BrainardLab/PennAnomaloscope/Electronics/ShieldFrontBlackPowerWires.jpeg

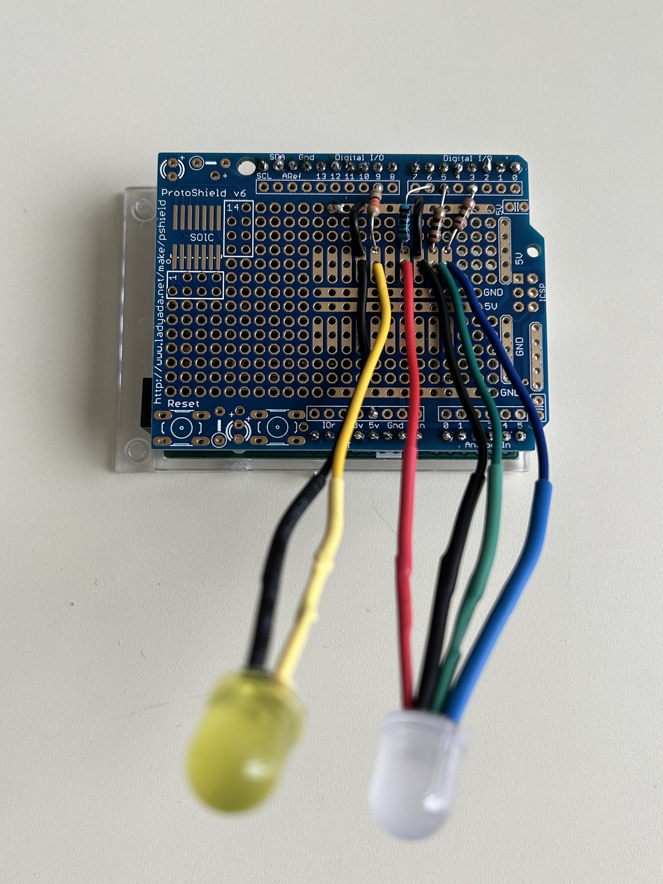
Electronics/ShieldFrontBlackPowerWires.jpeg
