BrainardLab/PennAnomaloscope/Electronics/ShieldBackBlackPowerWires.jpeg

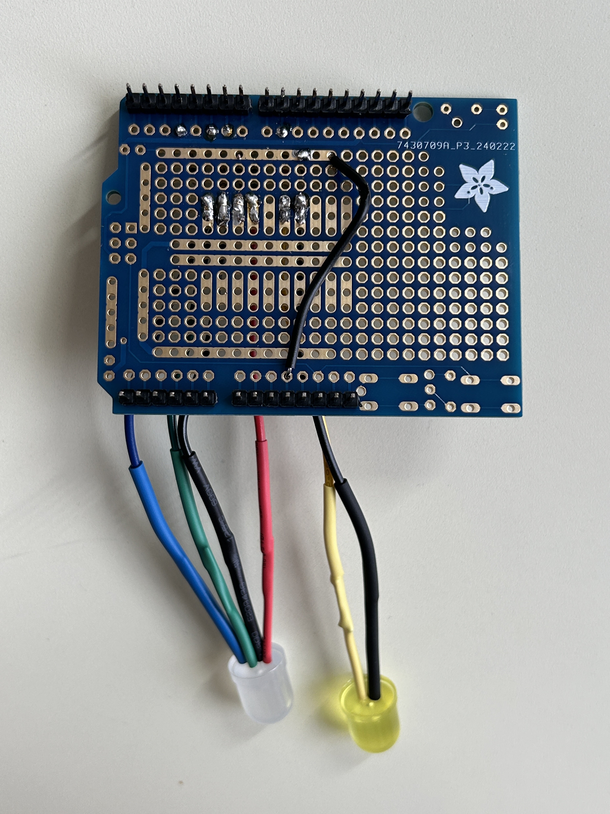
Electronics/ShieldBackBlackPowerWires.jpeg
