BrainardLab/PennAnomaloscope/Electronics/README.md

See the AssemblyInstructions document for instructions.
