BrainardLab/PennAnomaloscope/Electronics/PartsList-02-08-25.xlsx

Date | Company | Product | PID | Link | Price per Unit | # of Units | Cost | Order Cost w/ Tax & Shipping
2019-10-30 | Adafruit | Diffused RGB (tri-color) 10mm LED (10 / order) | 848 | https://www.adafruit.com/product/848 | $9.95 | 1 | $9.95 | $71.06
2019-10-30 | Adafruit | Diffused Yellow 10mm LED (25 / order) | 3260 | https://www.adafruit.com/product/3260 | $9.95 | 1 | $9.95
2019-10-30 | Adafruit | Extra-long 0.1" 16-pin strip male header (5 / order) | 400 | https://www.adafruit.com/product/400 | $3.00 | 5 | $15.00
2019-10-30 | Adafruit | Adafruit Proto Shield for Arduino V:R3 | 2077 | https://www.adafruit.com/product/2077 | $9.95 | 2 | $19.90
2020-03-26 | Prusa | Prusament ASA Natural 850g | PRM-ASA-NAT-850 | https://shop.prusa3d.com/en/prusament/976-prusament-asa-natural-850g.html | $29.99 | 1 | $29.99 | $32.09
2020-11-29 | B&H | Rosco Roscolux #23 Filter - Orange - 20x24" Sheet | BH #RO23S | https://www.bhphotovideo.com/c/product/43934-REG/Rosco_RS2311_23_Filter_Orange.html | $6.95 | 3 | $20.85 | $30.89
2021-05-03 | Prusa | Prusament ASA Signal White 850g | PRM-ASA-SGW-850 | https://shop.prusa3d.com/en/prusament/1318-prusament-asa-signal-white-850g.html | $28.49 | 2 | $56.98 | $72.52
2021-04-26 | Adafruit | Hook-up Wire Spool Set - 22AWG Solid Core | 1311 | https://www.adafruit.com/product/1311 | $15.95 | 1 | $15.95
2021-05-28 | Amazon | Arduino Leonardo with Headers | A000057 | https://www.amazon.com/gp/product/B008FZJC74/ref=ppx_od_dt_b_asin_title_s00?ie=UTF8&psc=1 | $25.15 | 11 | $276.65
 |  |  |  |  |  |  |  | $293.26
Alternates |  | Diffused yellow LED, 611 nm, 10mm diam | not in stock | https://www.digikey.com/en/products/detail/sunled/XLM2MOK01W/4901618?0=%2F605nm
 |  | Diffused yellow LED, 610 nm, 3mm diam | in stock | https://www.digikey.com/en/products/detail/broadcom-limited/HLMP-Y402-G0000/2672647
 |  | Diffused yellow LED, 605 nm, 10mm diam | in stock | https://www.adafruit.com/product/4204
