BrainardLab/PennAnomaloscope/arduino_spectra.pdf

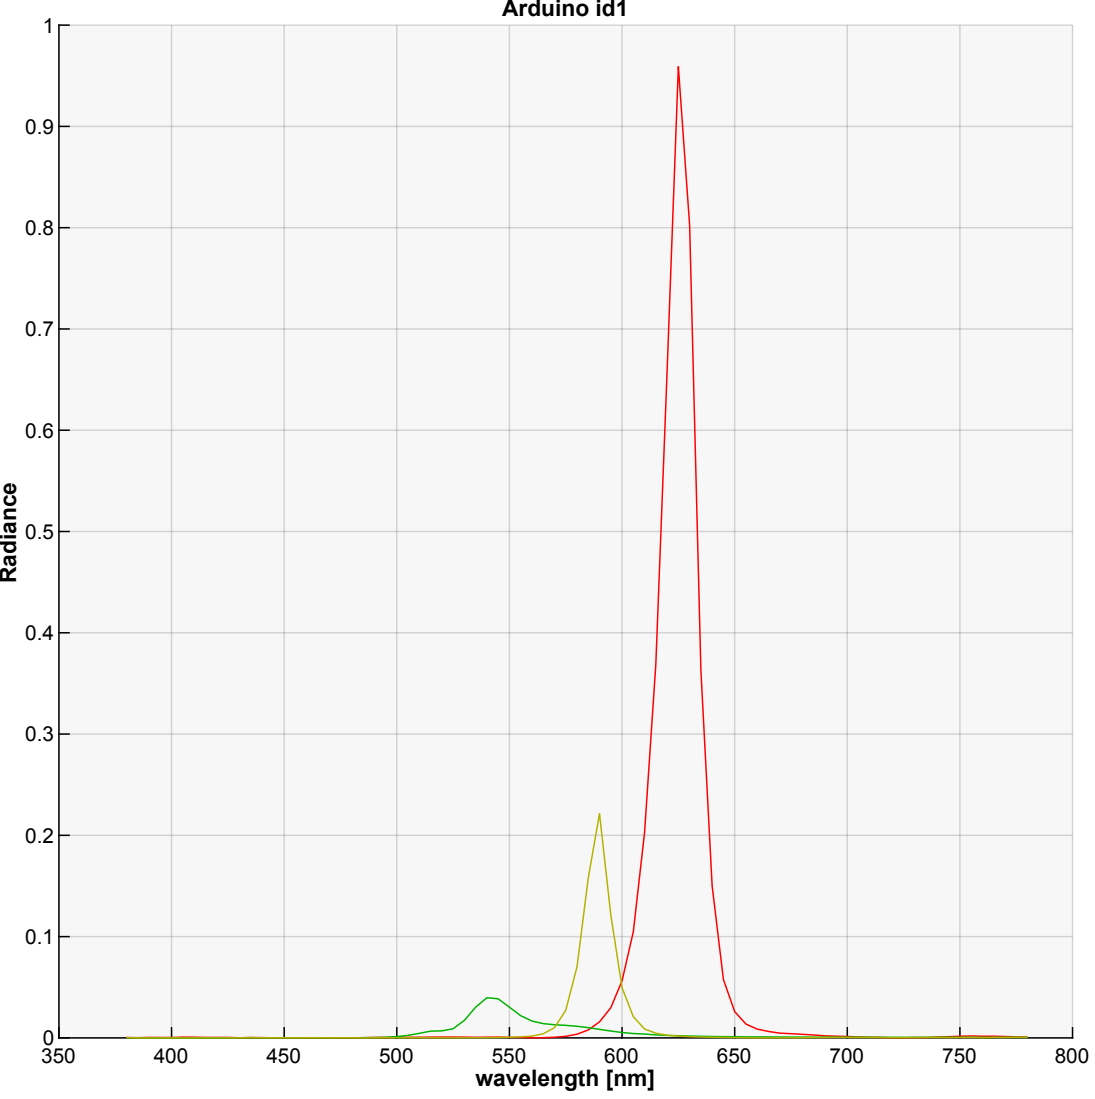
[picture p3: page 1]
800 wavelength [nm]; Radiance; Arduino id1
