BrainardLab/PennAnomaloscope/Code/GamePadCommandGuide.pptx

Increase Y

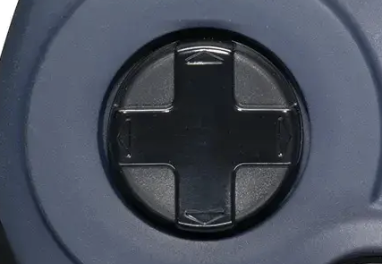
[picture p6: figure]

Decrease Y

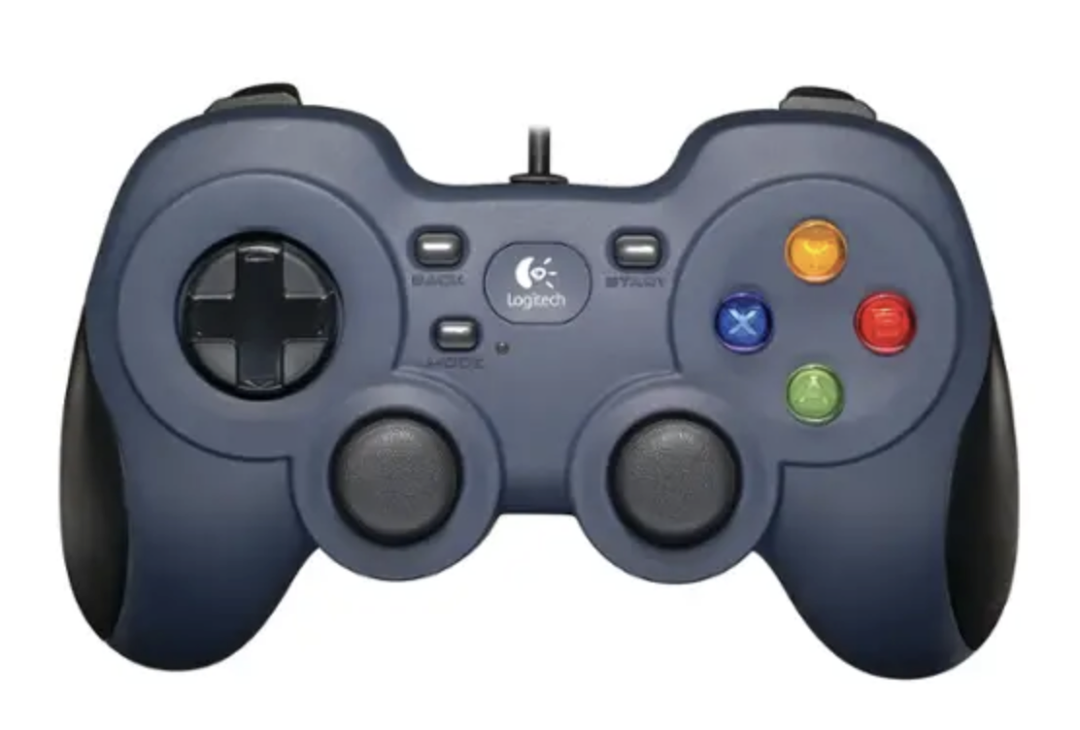
[picture p7: figure]

Quit

Accept and Save Match

Greener

Redder

Bigger Y Step

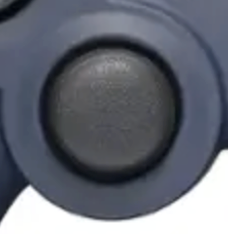
[picture p8: figure]

Smaller Y Step

Smaller
R/G Step

Bigger
R/G Step
