BrainardLab/PennAnomaloscope/Code/GamePadCommandGuide.png

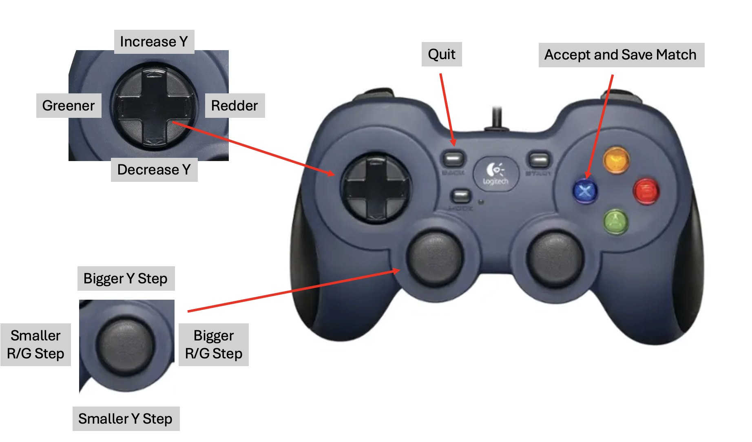
Code/GamePadCommandGuide.png
