BrainardLab/PennAnomaloscope/ICVS2025/ArduinoCalibrationFiles/ICVS2025_ArduinoCalNotes.docx

Number 4: Was marked “Mitch” but we removed that marking tape

Number 5: Had black tape on it and is marked “good green” Did not see seem to have any filters. We added some so now it is like the others.

Number 6: Can’t get it to work – something wrong with Arduino connection. Bad board?

Number 8: This one doesn’t have a filter and we measured RGB and Y.
