BrainardLab/PennAnomaloscope/(commit log)

2025-02-08 Updated parts list due to Alexander Gorkan
    [PartsList-02-08-25.xlsx, PartsListOrig.xlsx]
2025-02-12 Removing obsolete docs. See AssemblyInstructions document.
2025-03-04 Comment out game pad button diagnostic printout
2025-03-04 Fix crash when unassigned button is pressed
2025-05-01 Some changes to allow easier display of each primary for calibration.
2025-08-10 Adding ICVS2025 directory with calibration files
2025-08-10 Added some ICVS2025 calibration notes.
